ajcci/sky130_ajc_ip__por/doc/schematic/sky130_ajc_ip__por.html

# CACE 4.0 datasheet

sky130_ajc_ip__por

Power-on-reset

PDK: | sky130A

Designer: | Robin Matthew Tsang
Company: | Ajacci, Ltd. Co.
Created: | March 22, 2024
Last modified: | April 15, 2024 at 12:55pm
License: | Apache 2.0

## Pin names and descriptions


Project schematic symbol

pin name | description | type | direction | Vmin | Vmax | notes
vbg_1v2 | Bandgap reference 1.20V | signal | input | 1.15 | 1.25
otrip2:0 | Digital trip voltage select for brown-out detector | digital | input | dvss - 0.3 | dvdd + 0.3
force_pdn | Force power-down | digital | input | dvss - 0.3 | dvdd + 0.3
isrc_sel | Internal(0)/external(1) bias current select | digital | input | dvss - 0.3 | dvdd + 0.3
force_ena_rc_osc | Force internal rc-oscillator to turn on, test-mode | digital | input | dvss - 0.3 | dvdd + 0.3
force_dis_rc_osc | Force internal rc-oscillator to turn off, test-mode | digital | input | dvss - 0.3 | dvdd + 0.3
force_short_oneshot | Force one-shot timeout period to be very short, test-mode | digital | input | dvss - 0.3 | dvdd + 0.3
ibg_200n | External 200n bandgap reference current | signal | input | avss - 0.3 | avdd + 0.3
por | power-on-reset (active high) | digital | output | dvss - 0.3 | dvdd + 0.3
porb | power-on-reset (active low) | digital | output | dvss - 0.3 | dvdd + 0.3
porb_h | power-on-reset (active low 3v3) | digital | output | avss - 0.3 | avdd + 0.3
itest | Test current, send to external 1Mohm resistor if desired | signal | output | avss - 0.3 | avdd + 0.3
dvdd | Positive digital power supply | power | inout | 1.5 | 2.1
dvss | Digital ground | ground | inout | -0.3 | 0.3
avdd | Positive analog power supply | power | inout | 3.0 | 6.0
avss | Analog ground | ground | inout | -0.3 | 0.3
pwup_filt | Filtered analog comparator output, test-mode | digital | output | dvss - 0.3 | dvdd + 0.3
osc_ck | RC oscillator output | digital | output | dvss - 0.3 | dvdd + 0.3
vin | Analog input to comparator | signal | output | avss - 0.3 | avdd + 0.3
por_timed_out | Asserts high when one-shot timer expires after power-on-reset event ~50ms | digital | output | dvss - 0.3 | dvdd + 0.3
startup_timed_out | Asserts high when one-shot timer expires after initial powup-up for supply to stabilize ~1ms | digital | output | dvss - 0.3 | dvdd + 0.3
dcomp | Unfiltered analog comparator output, test-mode | digital | output | dvss - 0.3 | dvdd + 0.3

## Default conditions

name | description | unit | minimum | typical | maximum | notes
dvdd | Digital power supply voltage | V | | 1.8
dvss | Digital ground | V | | 0
avdd | Analog power supply voltage | V | | 3.3
avss | Analog ground | V | | 0
cload | Output load capatitance | pF | | | 20
force_pdn | Force diable of power-on-reset circuit | | | 0
isrc_sel | Internal(0)/external(1) bias current select | | | 0
force_ena_rc_osc | Force internal rc-oscillator to turn on, test-mode | | | 0
force_dis_rc_osc | Force internal rc-oscillator to turn on, test-mode | | | 0
force_short_oneshot | Force one-shot timeout period to be very short, test-mode | | | 0
otrip[2:0] | Brown-out trip voltage digital input value | | | 100
Temp | Ambient temperature | °C | -40 | 27 | 130
Corner | Process corner | | ss | tt | ff

## Electrical parameters

name | description | unit | minimum | typical | maximum | notes
Hysteresis (out) | Check amount of hysteresis at each trip voltage | V | 0.1138 | 0.1557 | 0.2062
Accuracy (out) | Check absolute accuracy of trip voltages (avg of pos- and neg-ramp trip voltages) | V | -0.002 | -0.001057 | 0.00208
Startup time (actual) | Measure time between when avdd crosses trip voltage to when POR reset is active, allows power supply to stabilize | ms | 0.7217 | 0.9965 | 1.558
Reset active time (est.) | Estimate reset active time by check rc oscillator period across 10 cycles, then multiplying by 2048. | ms | 40.23 | 54.01 | 88.05
Idd | Current draw through analog supply, POR enabled | µA | 4.322 | 4.555 | 4.711
Standby current | Current draw through analog supply, POR disabled | µA | 0.001176 | 0.001811 | 0.03704

Note: Values taken from Schematic captured


Demo of power-on-reset during a supply ramp and supply glitch with test-mode force_short_oneshot enabled. Shortens startup to and reset active windows to 4 and 8 osc_ck cycles, from 32 and 2048 osc_ck cycles.
(Values taken from schematic extraction)
