ajcci/sky130_ajc_ip__por/openlane/por_dig/runs/RUN_2024-04-15_08-19-42/50-openroad-irdropreport/net-VPWR.csv

Instance name | X location | Y location | Voltage
FILLER_0_16_29 | 21.84 | 57.12 | 1.8
_098_ | 21.84 | 51.68 | 1.8
_103_ | 21.84 | 51.68 | 1.8
_124_ | 21.84 | 51.68 | 1.8
hold4 | 21.84 | 51.68 | 1.8
_058_ | 21.84 | 46.24 | 1.8
_073_ | 21.84 | 46.24 | 1.8
_101_ | 21.84 | 46.24 | 1.8
_102_ | 21.84 | 46.24 | 1.8
_105_ | 21.84 | 46.24 | 1.8
FILLER_0_14_37 | 21.84 | 46.24 | 1.8
_055_ | 21.84 | 40.8 | 1.8
_059_ | 21.84 | 40.8 | 1.8
_060_ | 21.84 | 40.8 | 1.8
_084_ | 21.84 | 40.8 | 1.8
_097_ | 21.84 | 40.8 | 1.8
hold12 | 21.84 | 40.8 | 1.8
FILLER_0_11_37 | 21.84 | 40.8 | 1.8
_114_ | 21.84 | 35.36 | 1.8
_123_ | 21.84 | 35.36 | 1.8
clkbuf_0_osc_ck | 21.84 | 35.36 | 1.8
_074_ | 21.84 | 29.92 | 1.8
_106_ | 21.84 | 29.92 | 1.8
hold8 | 21.84 | 29.92 | 1.8
hold9 | 21.84 | 29.92 | 1.8
_072_ | 21.84 | 24.48 | 1.8
_115_ | 21.84 | 24.48 | 1.8
_116_ | 21.84 | 24.48 | 1.8
_075_ | 21.84 | 19.04 | 1.8
_077_ | 21.84 | 19.04 | 1.8
output12 | 21.84 | 19.04 | 1.8
fanout24 | 21.84 | 19.04 | 1.8
hold1 | 21.84 | 19.04 | 1.8
FILLER_0_2_35 | 21.84 | 19.04 | 1.8
FILLER_0_3_38 | 21.84 | 19.04 | 1.8
_062_ | 21.84 | 13.6 | 1.8
_063_ | 21.84 | 13.6 | 1.8
_065_ | 21.84 | 13.6 | 1.8
_068_ | 21.84 | 13.6 | 1.8
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
