ajcci/sky130_ajc_ip__por/coupling_caps_extraction_slowest_corner.png

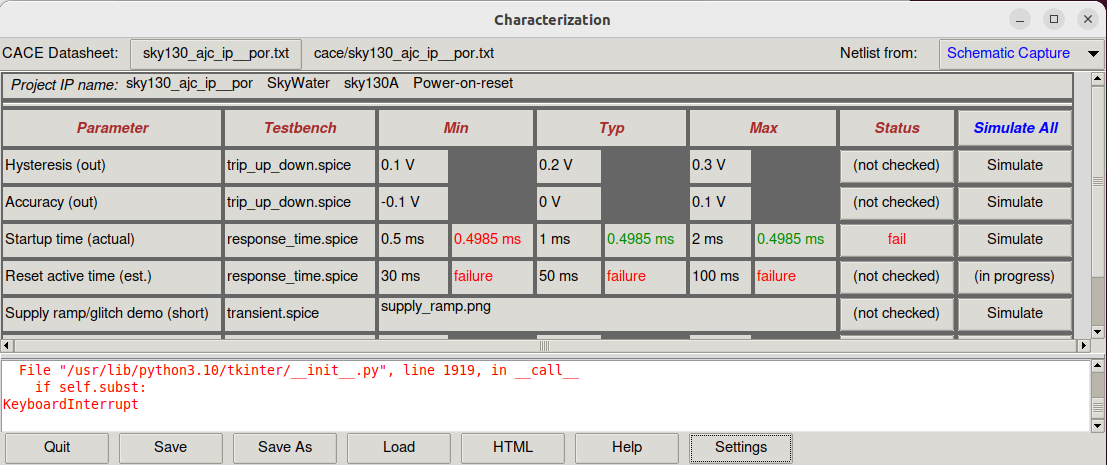
coupling_caps_extraction_slowest_corner.png
