ajcci/sky130_ajc_ip__por/plots/schematic/supply_ramp.png

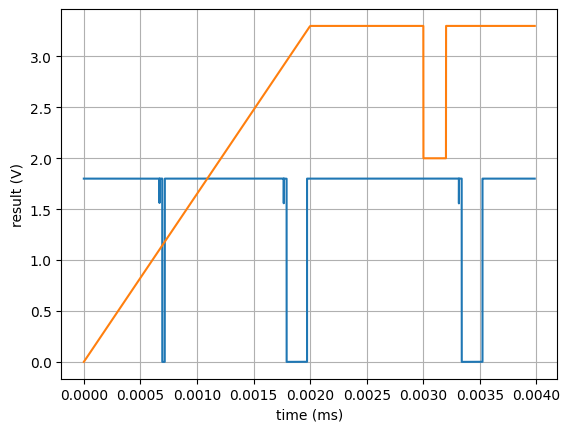
plots/schematic/supply_ramp.png
