ajcci/sky130_ajc_ip__por/unconnected_node_coupling_caps_extraction.png

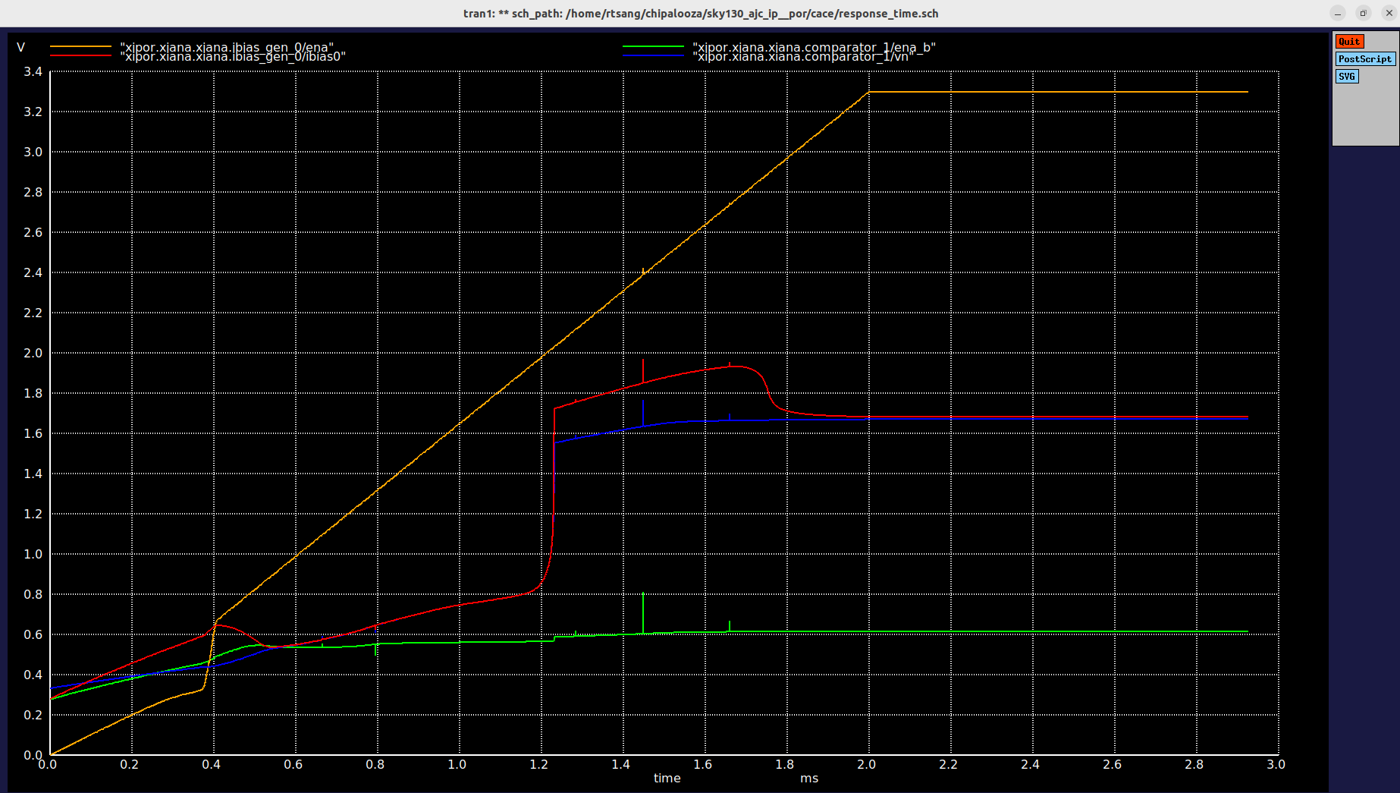
unconnected_node_coupling_caps_extraction.png
