ajcci/sky130_ajc_ip__por/cace/dccurrent_avdd.spice

** sch_path: /home/rtsang/chipalooza/sky130_ajc_ip__por/cace/dccurrent_avdd.sch
**.subckt dccurrent_avdd
Ibias vbp GND 200n
XM1 ibg_200n vbp avdd_bg avdd_bg sky130_fd_pr__pfet_g5v0d10v5 L=4 W=1 nf=1 ad='int((nf+1)/2) * W/nf * 0.29' as='int((nf+2)/2) * W/nf * 0.29'
+ pd='2*int((nf+1)/2) * (W/nf + 0.29)' ps='2*int((nf+2)/2) * (W/nf + 0.29)' nrd='0.29 / W' nrs='0.29 / W' sa=0 sb=0 sd=0 mult=1 m=1
XM0 vbp vbp avdd_bg avdd_bg sky130_fd_pr__pfet_g5v0d10v5 L=4 W=1 nf=1 ad='int((nf+1)/2) * W/nf * 0.29' as='int((nf+2)/2) * W/nf * 0.29'
+ pd='2*int((nf+1)/2) * (W/nf + 0.29)' ps='2*int((nf+2)/2) * (W/nf + 0.29)' nrd='0.29 / W' nrs='0.29 / W' sa=0 sb=0 sd=0 mult=1 m=1
Vavss avss GND DC {Vavss}
Vena force_pdn GND DC [{force_pdn}*{Vdvdd}]
Vavdd avdd GND DC {Vavdd}
.save i(vavdd)
Vbg1v2 vbg_1v2 GND DC 1.2
Vdvss dvss GND DC {Vdvss}
Vdvdd dvdd GND DC {Vdvdd}
.save i(vdvdd)
Vvotrip0 otrip[0] GND DC [{otrip[0]}*{Vdvdd}]
.save i(vvotrip0)
Vvotrip1 otrip[1] GND DC [{otrip[1]}*{Vdvdd}]
.save i(vvotrip1)
Vvotrip2 otrip[2] GND DC [{otrip[2]}*{Vdvdd}]
.save i(vvotrip2)
Vvotrip3 otrip[3] GND DC [{otrip[3]}*{Vdvdd}]
.save i(vvotrip3)
Visrc_sel isrc_sel GND DC [{isrc_sel}*{Vdvdd}]
Vavdd_bg avdd_bg GND DC 3.3
Vforce_dis_rc_osc force_dis_rc_osc GND DC [{force_dis_rc_osc}*{Vdvdd}]
Vforce_short_oneshot force_short_oneshot GND DC [{force_short_oneshot}*{Vdvdd}]
Vforce_ena_rc_osc force_ena_rc_osc GND DC [{force_ena_rc_osc}*{Vdvdd}]
R1 itest GND 1e6 m=1
xIpor avdd porb_h porb avss dvdd por dvss osc_ck vbg_1v2 dcomp otrip[2] otrip[1] otrip[0] itest force_pdn pwup_filt vin
+ force_ena_rc_osc force_dis_rc_osc startup_timed_out por_timed_out force_short_oneshot isrc_sel ibg_200n sky130_ajc_ip__por
C1 porb_h GND 20p m=1
C2 porb GND 20p m=1
C3 por GND 20p m=1
**** begin user architecture code

* CACE gensim simulation file {filename}_{N}
* Generated by CACE gensim, Efabless Corporation (c) 2023
* Find trip voltage by ramping Vavdd, both up and down.

.lib {PDK_ROOT}/{PDK}/libs.tech/combined/sky130.lib.spice {corner}
.include {PDK_ROOT}/{PDK}/libs.ref/sky130_fd_sc_hvl/spice/sky130_fd_sc_hvl.spice
.include {PDK_ROOT}/{PDK}/libs.ref/sky130_fd_sc_hd/spice/sky130_fd_sc_hd.spice

.option TEMP={temperature}
* Flag unsafe operating conditions (exceeds models' specified limits)
.option warn=1

.option reltol=1e-3
.option abstol=1e-3

.save all



.control
op
set wr_singlescale
wrdata {simpath}/{filename}_{N}.data -I(Vavdd)
quit
.endc


**** end user architecture code
**.ends

* expanding   symbol:  xschem/sky130_ajc_ip__por.sym # of pins=22
** sym_path: /home/rtsang/chipalooza/sky130_ajc_ip__por/xschem/sky130_ajc_ip__por.sym
** sch_path: /home/rtsang/chipalooza/sky130_ajc_ip__por/xschem/sky130_ajc_ip__por.sch
.subckt sky130_ajc_ip__por avdd porb_h porb avss dvdd por dvss osc_ck vbg_1v2 dcomp otrip[2] otrip[1] otrip[0] itest force_pdn pwup_filt vin force_ena_rc_osc force_dis_rc_osc startup_timed_out por_timed_out force_short_oneshot isrc_sel ibg_200n
*.ipin avdd
*.ipin avss
*.ipin dvdd
*.ipin dvss
*.ipin vbg_1v2
*.ipin otrip[2],otrip[1],otrip[0]
*.ipin force_pdn
*.ipin force_ena_rc_osc
*.ipin force_short_oneshot
*.ipin isrc_sel
*.ipin ibg_200n
*.opin vin
*.opin porb_h
*.opin porb
*.opin por
*.opin osc_ck
*.opin pwup_filt
*.opin itest
*.opin startup_timed_out
*.opin por_timed_out
*.ipin force_dis_rc_osc
*.opin dcomp
xIana vin otrip_decoded_7_ otrip_decoded_6_ otrip_decoded_5_ otrip_decoded_4_ otrip_decoded_3_ otrip_decoded_2_ otrip_decoded_1_ otrip_decoded_0_ vbg_1v2 avdd itest avss ibg_200n force_pdnb dvdd dvss dcomp isrc_sel pwup_filt osc_ck osc_ena porb_h por_unbuf por porb por_ana
**** begin user architecture code



r0 otrip[0] otrip0 1
r1 otrip[1] otrip1 1
r2 otrip[2] otrip2 1

*XSPICE CO-SIM netlist
.include por_dig.out.spice
xipor_dig dvss dvdd force_dis_rc_osc force_ena_rc_osc force_pdn force_pdnb force_short_oneshot osc_ck osc_ena
+otrip0 otrip1 otrip2
+otrip_decoded_0_ otrip_decoded_1_ otrip_decoded_2_ otrip_decoded_3_ otrip_decoded_4_ otrip_decoded_5_ otrip_decoded_6_ otrip_decoded_7_
+por_timed_out por_unbuf pwup_filt startup_timed_out por_dig


**** end user architecture code
.ends


* expanding   symbol:  xschem/por_ana.sym # of pins=19
** sym_path: /home/rtsang/chipalooza/sky130_ajc_ip__por/xschem/por_ana.sym
** sch_path: /home/rtsang/chipalooza/sky130_ajc_ip__por/xschem/por_ana.sch
.subckt por_ana vin otrip_decoded[7] otrip_decoded[6] otrip_decoded[5] otrip_decoded[4] otrip_decoded[3] otrip_decoded[2] otrip_decoded[1] otrip_decoded[0] vbg_1v2 avdd itest avss ibg_200n force_pdnb dvdd dvss dcomp isrc_sel pwup_filt osc_ck osc_ena porb_h por_unbuf por porb
*.ipin vbg_1v2
*.ipin avdd
*.ipin avss
*.ipin dvdd
*.ipin dvss
*.ipin force_pdnb
*.ipin isrc_sel
*.ipin ibg_200n
*.opin pwup_filt
*.opin itest
*.ipin osc_ena
*.opin osc_ck
*.ipin otrip_decoded[7],otrip_decoded[6],otrip_decoded[5],otrip_decoded[4],otrip_decoded[3],otrip_decoded[2],otrip_decoded[1],otrip_decoded[0]
*.opin vin
*.ipin por_unbuf
*.opin porb_h
*.opin por
*.opin porb
*.opin dcomp
xIlvls0 dcomp3v3 dvdd dvss dvss avdd avdd vl sky130_fd_sc_hvl__lsbufhv2lv_1
XC2 dcomp_filt dvss sky130_fd_pr__cap_mim_m3_2 W=30 L=30 MF=6 m=6
xIlvls0[7] otrip_decoded[7] dvdd dvss dvss avdd avdd otrip_decoded_avdd[7] sky130_fd_sc_hvl__lsbuflv2hv_1
xIlvls0[6] otrip_decoded[6] dvdd dvss dvss avdd avdd otrip_decoded_avdd[6] sky130_fd_sc_hvl__lsbuflv2hv_1
xIlvls0[5] otrip_decoded[5] dvdd dvss dvss avdd avdd otrip_decoded_avdd[5] sky130_fd_sc_hvl__lsbuflv2hv_1
xIlvls0[4] otrip_decoded[4] dvdd dvss dvss avdd avdd otrip_decoded_avdd[4] sky130_fd_sc_hvl__lsbuflv2hv_1
xIlvls0[3] otrip_decoded[3] dvdd dvss dvss avdd avdd otrip_decoded_avdd[3] sky130_fd_sc_hvl__lsbuflv2hv_1
xIlvls0[2] otrip_decoded[2] dvdd dvss dvss avdd avdd otrip_decoded_avdd[2] sky130_fd_sc_hvl__lsbuflv2hv_1
xIlvls0[1] otrip_decoded[1] dvdd dvss dvss avdd avdd otrip_decoded_avdd[1] sky130_fd_sc_hvl__lsbuflv2hv_1
xIlvls0[0] otrip_decoded[0] dvdd dvss dvss avdd avdd otrip_decoded_avdd[0] sky130_fd_sc_hvl__lsbuflv2hv_1
xIlvls1 force_pdnb dvdd dvss dvss avdd avdd force_pdnb_avdd sky130_fd_sc_hvl__lsbuflv2hv_1
xIlvls2 isrc_sel dvdd dvss dvss avdd avdd isrc_sel_avdd sky130_fd_sc_hvl__lsbuflv2hv_1
xIrsmux avdd vin force_pdnb_avdd otrip_decoded_avdd[7] otrip_decoded_avdd[6] otrip_decoded_avdd[5] otrip_decoded_avdd[4] otrip_decoded_avdd[3] otrip_decoded_avdd[2] otrip_decoded_avdd[1] otrip_decoded_avdd[0] vtrip_decoded_avdd[7] vtrip_decoded_avdd[6] vtrip_decoded_avdd[5] vtrip_decoded_avdd[4] vtrip_decoded_avdd[3] vtrip_decoded_avdd[2] vtrip_decoded_avdd[1] vtrip_decoded_avdd[0] not_used avss rstring_mux
xIcomp avdd ibias0 dcomp3v3 force_pdnb_avdd vbg_1v2 vin avss comparator
xIbiasgen avdd ibias0 itest ibias1 ibg_200n vbg_1v2 isrc_sel_avdd force_pdnb_avdd net8 avss ibias_gen
xIosc dvdd osc_ck osc_ena dvss rc_osc
xIlvls3 por_unbuf dvdd dvss dvss avdd avdd net1 sky130_fd_sc_hvl__lsbuflv2hv_1
xIinv4 por_unbuf dvss dvss dvdd dvdd net4 sky130_fd_sc_hd__inv_4
xIinv5 net4 dvss dvss dvdd dvdd por sky130_fd_sc_hd__inv_16
xIinv7 net6 dvss dvss dvdd dvdd net5 sky130_fd_sc_hd__inv_4
xIinv88 net5 dvss dvss dvdd dvdd porb sky130_fd_sc_hd__inv_16
xIinv6 por_unbuf dvss dvss dvdd dvdd net6 sky130_fd_sc_hd__inv_4
xIinv8 net3 avss avss avdd avdd porb_h sky130_fd_sc_hvl__inv_16
xIinv2 net2 avss avss avdd avdd net3 sky130_fd_sc_hvl__inv_4
xIinv1 net1 avss avss avdd avdd net2 sky130_fd_sc_hvl__inv_1
xIschmitt dvdd dcomp_filt vsch dvss schmitt_trigger
xIinv3 net7 dvss dvss dvdd dvdd pwup_filt sky130_fd_sc_hd__inv_16
xIinv9 vsch dvss dvss dvdd dvdd net7 sky130_fd_sc_hd__inv_4
XR2 dcomp_filt vl avss sky130_fd_pr__res_xhigh_po_1p41 L=700 mult=1 m=1
xIlvls3[7] dvss dvdd dvss dvss avdd avdd vtrip_decoded_avdd[7] sky130_fd_sc_hvl__lsbuflv2hv_1
xIlvls3[6] dvss dvdd dvss dvss avdd avdd vtrip_decoded_avdd[6] sky130_fd_sc_hvl__lsbuflv2hv_1
xIlvls3[5] dvss dvdd dvss dvss avdd avdd vtrip_decoded_avdd[5] sky130_fd_sc_hvl__lsbuflv2hv_1
xIlvls3[4] dvss dvdd dvss dvss avdd avdd vtrip_decoded_avdd[4] sky130_fd_sc_hvl__lsbuflv2hv_1
xIlvls3[3] dvss dvdd dvss dvss avdd avdd vtrip_decoded_avdd[3] sky130_fd_sc_hvl__lsbuflv2hv_1
xIlvls3[2] dvss dvdd dvss dvss avdd avdd vtrip_decoded_avdd[2] sky130_fd_sc_hvl__lsbuflv2hv_1
xIlvls3[1] dvss dvdd dvss dvss avdd avdd vtrip_decoded_avdd[1] sky130_fd_sc_hvl__lsbuflv2hv_1
xIlvls3[0] dvss dvdd dvss dvss avdd avdd vtrip_decoded_avdd[0] sky130_fd_sc_hvl__lsbuflv2hv_1
xIcomp_vunder avdd ibias1 net9 avss not_used vbg_1v2 avss comparator
xIlvls5 net9 dvdd dvss dvss avdd avdd vlu sky130_fd_sc_hvl__lsbufhv2lv_1
* noconn vlu
xIinv10 vl dvss dvss dvdd dvdd net10 sky130_fd_sc_hd__inv_4
xIinv11 net10 dvss dvss dvdd dvdd dcomp sky130_fd_sc_hd__inv_16
XQ1 avss avss net8 avss sky130_fd_pr__pnp_05v5_W0p68L0p68 m=1 mult=1
.ends


* expanding   symbol:  rstring_mux.sym # of pins=7
** sym_path: /home/rtsang/chipalooza/sky130_ajc_ip__por/cace/rstring_mux.sym
** sch_path: /home/rtsang/chipalooza/sky130_ajc_ip__por/cace/rstring_mux.sch
.subckt rstring_mux avdd vout_brout ena otrip_decoded_avdd[7] otrip_decoded_avdd[6] otrip_decoded_avdd[5] otrip_decoded_avdd[4] otrip_decoded_avdd[3] otrip_decoded_avdd[2] otrip_decoded_avdd[1] otrip_decoded_avdd[0] vtrip_decoded_avdd[7] vtrip_decoded_avdd[6] vtrip_decoded_avdd[5] vtrip_decoded_avdd[4] vtrip_decoded_avdd[3] vtrip_decoded_avdd[2] vtrip_decoded_avdd[1] vtrip_decoded_avdd[0] vout_vunder avss
*.opin vout_brout
*.ipin otrip_decoded_avdd[7],otrip_decoded_avdd[6],otrip_decoded_avdd[5],otrip_decoded_avdd[4],otrip_decoded_avdd[3],otrip_decoded_avdd[2],otrip_decoded_avdd[1],otrip_decoded_avdd[0]
*.opin vout_vunder
*.ipin vtrip_decoded_avdd[7],vtrip_decoded_avdd[6],vtrip_decoded_avdd[5],vtrip_decoded_avdd[4],vtrip_decoded_avdd[3],vtrip_decoded_avdd[2],vtrip_decoded_avdd[1],vtrip_decoded_avdd[0]
*.ipin ena
*.ipin avdd
*.ipin avss
XR1 net2 net3 avss sky130_fd_pr__res_xhigh_po_1p41 L=35 mult=1 m=1
XR2 net3 net4 avss sky130_fd_pr__res_xhigh_po_1p41 L=35 mult=1 m=1
XR0 avss net2 avss sky130_fd_pr__res_xhigh_po_1p41 L=35 mult=1 m=1
XR3 net4 net5 avss sky130_fd_pr__res_xhigh_po_1p41 L=35 mult=1 m=1
XR4 net5 net6 avss sky130_fd_pr__res_xhigh_po_1p41 L=35 mult=1 m=1
XR5 net6 net7 avss sky130_fd_pr__res_xhigh_po_1p41 L=35 mult=1 m=1
XR6 net7 net8 avss sky130_fd_pr__res_xhigh_po_1p41 L=35 mult=1 m=1
XR7 net8 net9 avss sky130_fd_pr__res_xhigh_po_1p41 L=35 mult=1 m=1
XR8 net9 net10 avss sky130_fd_pr__res_xhigh_po_1p41 L=35 mult=1 m=1
XR9 net10 net11 avss sky130_fd_pr__res_xhigh_po_1p41 L=35 mult=1 m=1
XR10 net11 net12 avss sky130_fd_pr__res_xhigh_po_1p41 L=35 mult=1 m=1
XR11 net12 net13 avss sky130_fd_pr__res_xhigh_po_1p41 L=35 mult=1 m=1
XR12 net13 net14 avss sky130_fd_pr__res_xhigh_po_1p41 L=35 mult=1 m=1
XR13 net14 net15 avss sky130_fd_pr__res_xhigh_po_1p41 L=35 mult=1 m=1
XR14 net15 net16 avss sky130_fd_pr__res_xhigh_po_1p41 L=35 mult=1 m=1
XR15 net16 net17 avss sky130_fd_pr__res_xhigh_po_1p41 L=35 mult=1 m=1
XR16 net17 net18 avss sky130_fd_pr__res_xhigh_po_1p41 L=35 mult=1 m=1
XR17 net18 net19 avss sky130_fd_pr__res_xhigh_po_1p41 L=35 mult=1 m=1
XR18 net19 net20 avss sky130_fd_pr__res_xhigh_po_1p41 L=35 mult=1 m=1
XR19 net20 net21 avss sky130_fd_pr__res_xhigh_po_1p41 L=35 mult=1 m=1
XR20 net21 net22 avss sky130_fd_pr__res_xhigh_po_1p41 L=35 mult=1 m=1
XR21 net22 net23 avss sky130_fd_pr__res_xhigh_po_1p41 L=35 mult=1 m=1
XR22 net23 net24 avss sky130_fd_pr__res_xhigh_po_1p41 L=35 mult=1 m=1
XR23 net24 net25 avss sky130_fd_pr__res_xhigh_po_1p41 L=35 mult=1 m=1
XR24 net25 net26 avss sky130_fd_pr__res_xhigh_po_1p41 L=35 mult=1 m=1
XR25 net26 net27 avss sky130_fd_pr__res_xhigh_po_1p41 L=35 mult=1 m=1
XR26 net27 net28 avss sky130_fd_pr__res_xhigh_po_1p41 L=35 mult=1 m=1
XR27 net28 vtrip7 avss sky130_fd_pr__res_xhigh_po_1p41 L=35 mult=1 m=1
XR28 vtrip7 vtrip6 avss sky130_fd_pr__res_xhigh_po_1p41 L=35 mult=1 m=1
XR29 vtrip6 vtrip5 avss sky130_fd_pr__res_xhigh_po_1p41 L=35 mult=1 m=1
XR30 vtrip5 vtrip4 avss sky130_fd_pr__res_xhigh_po_1p41 L=35 mult=1 m=1
XR31 vtrip4 vtrip3 avss sky130_fd_pr__res_xhigh_po_1p41 L=35 mult=1 m=1
XR32 vtrip3 vtrip2 avss sky130_fd_pr__res_xhigh_po_1p41 L=35 mult=1 m=1
XR33 vtrip2 vtrip1 avss sky130_fd_pr__res_xhigh_po_1p41 L=35 mult=1 m=1
XR34 vtrip1 vtrip0 avss sky130_fd_pr__res_xhigh_po_1p41 L=35 mult=1 m=1
XR35 vtrip0 net29 avss sky130_fd_pr__res_xhigh_po_1p41 L=35 mult=1 m=1
XR36 net29 net30 avss sky130_fd_pr__res_xhigh_po_1p41 L=35 mult=1 m=1
XR37 net30 net31 avss sky130_fd_pr__res_xhigh_po_1p41 L=35 mult=1 m=1
XR38 net31 net32 avss sky130_fd_pr__res_xhigh_po_1p41 L=35 mult=1 m=1
XR39 net32 net33 avss sky130_fd_pr__res_xhigh_po_1p41 L=35 mult=1 m=1
XR40 net33 net34 avss sky130_fd_pr__res_xhigh_po_1p41 L=35 mult=1 m=1
XR41 net34 net35 avss sky130_fd_pr__res_xhigh_po_1p41 L=35 mult=1 m=1
XR42 net35 net36 avss sky130_fd_pr__res_xhigh_po_1p41 L=35 mult=1 m=1
XR43 net36 net37 avss sky130_fd_pr__res_xhigh_po_1p41 L=35 mult=1 m=1
XR44 net37 net38 avss sky130_fd_pr__res_xhigh_po_1p41 L=35 mult=1 m=1
XR45 net38 net39 avss sky130_fd_pr__res_xhigh_po_1p41 L=35 mult=1 m=1
XR46 net39 net40 avss sky130_fd_pr__res_xhigh_po_1p41 L=35 mult=1 m=1
XR47 net40 net41 avss sky130_fd_pr__res_xhigh_po_1p41 L=35 mult=1 m=1
XR48 net41 net42 avss sky130_fd_pr__res_xhigh_po_1p41 L=35 mult=1 m=1
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
XMtn1[2] vout_vunder vtrip_decoded_avdd[2] vtrip2 avss sky130_fd_pr__nfet_g5v0d10v5 L=0.6 W=5 nf=1 ad='int((nf+1)/2) * W/nf * 0.29' as='int((nf+2)/2)
+ * W/nf * 0.29' pd='2*int((nf+1)/2) * (W/nf + 0.29)' ps='2*int((nf+2)/2) * (W/nf + 0.29)' nrd='0.29 / W' nrs='0.29 / W' sa=0 sb=0 sd=0 mult=2 m=2
XMtn1[1] vout_vunder vtrip_decoded_avdd[1] vtrip1 avss sky130_fd_pr__nfet_g5v0d10v5 L=0.6 W=5 nf=1 ad='int((nf+1)/2) * W/nf * 0.29' as='int((nf+2)/2)
+ * W/nf * 0.29' pd='2*int((nf+1)/2) * (W/nf + 0.29)' ps='2*int((nf+2)/2) * (W/nf + 0.29)' nrd='0.29 / W' nrs='0.29 / W' sa=0 sb=0 sd=0 mult=2 m=2
XMtn1[0] vout_vunder vtrip_decoded_avdd[0] vtrip0 avss sky130_fd_pr__nfet_g5v0d10v5 L=0.6 W=5 nf=1 ad='int((nf+1)/2) * W/nf * 0.29' as='int((nf+2)/2)
+ * W/nf * 0.29' pd='2*int((nf+1)/2) * (W/nf + 0.29)' ps='2*int((nf+2)/2) * (W/nf + 0.29)' nrd='0.29 / W' nrs='0.29 / W' sa=0 sb=0 sd=0 mult=2 m=2
xIinv0[7] otrip_decoded_avdd[7] avss avss avdd avdd otrip_decoded_b_avdd[7] sky130_fd_sc_hvl__inv_1
xIinv0[6] otrip_decoded_avdd[6] avss avss avdd avdd otrip_decoded_b_avdd[6] sky130_fd_sc_hvl__inv_1
xIinv0[5] otrip_decoded_avdd[5] avss avss avdd avdd otrip_decoded_b_avdd[5] sky130_fd_sc_hvl__inv_1
xIinv0[4] otrip_decoded_avdd[4] avss avss avdd avdd otrip_decoded_b_avdd[4] sky130_fd_sc_hvl__inv_1
xIinv0[3] otrip_decoded_avdd[3] avss avss avdd avdd otrip_decoded_b_avdd[3] sky130_fd_sc_hvl__inv_1
xIinv0[2] otrip_decoded_avdd[2] avss avss avdd avdd otrip_decoded_b_avdd[2] sky130_fd_sc_hvl__inv_1
xIinv0[1] otrip_decoded_avdd[1] avss avss avdd avdd otrip_decoded_b_avdd[1] sky130_fd_sc_hvl__inv_1
xIinv0[0] otrip_decoded_avdd[0] avss avss avdd avdd otrip_decoded_b_avdd[0] sky130_fd_sc_hvl__inv_1
xIinv1[7] vtrip_decoded_avdd[7] avss avss avdd avdd vtrip_decoded_b_avdd[7] sky130_fd_sc_hvl__inv_1
xIinv1[6] vtrip_decoded_avdd[6] avss avss avdd avdd vtrip_decoded_b_avdd[6] sky130_fd_sc_hvl__inv_1
xIinv1[5] vtrip_decoded_avdd[5] avss avss avdd avdd vtrip_decoded_b_avdd[5] sky130_fd_sc_hvl__inv_1
xIinv1[4] vtrip_decoded_avdd[4] avss avss avdd avdd vtrip_decoded_b_avdd[4] sky130_fd_sc_hvl__inv_1
xIinv1[3] vtrip_decoded_avdd[3] avss avss avdd avdd vtrip_decoded_b_avdd[3] sky130_fd_sc_hvl__inv_1
xIinv1[2] vtrip_decoded_avdd[2] avss avss avdd avdd vtrip_decoded_b_avdd[2] sky130_fd_sc_hvl__inv_1
xIinv1[1] vtrip_decoded_avdd[1] avss avss avdd avdd vtrip_decoded_b_avdd[1] sky130_fd_sc_hvl__inv_1
xIinv1[0] vtrip_decoded_avdd[0] avss avss avdd avdd vtrip_decoded_b_avdd[0] sky130_fd_sc_hvl__inv_1
xIinv2 ena avss avss avdd avdd ena_b sky130_fd_sc_hvl__inv_1
XMpdn net1 ena_b avss avss sky130_fd_pr__nfet_g5v0d10v5 L=1 W=1 nf=1 ad='int((nf+1)/2) * W/nf * 0.29' as='int((nf+2)/2) * W/nf * 0.29' pd='2*int((nf+1)/2)
+ * (W/nf + 0.29)' ps='2*int((nf+2)/2) * (W/nf + 0.29)' nrd='0.29 / W' nrs='0.29 / W' sa=0 sb=0 sd=0 mult=1 m=1
XMpdp avdd ena_b net1 avdd sky130_fd_pr__pfet_g5v0d10v5 L=0.6 W=5 nf=1 ad='int((nf+1)/2) * W/nf * 0.29' as='int((nf+2)/2) * W/nf *
+ 0.29' pd='2*int((nf+1)/2) * (W/nf + 0.29)' ps='2*int((nf+2)/2) * (W/nf + 0.29)' nrd='0.29 / W' nrs='0.29 / W' sa=0 sb=0 sd=0 mult=16 m=16
XMdum0 vout_brout avdd vout_brout avdd sky130_fd_pr__pfet_g5v0d10v5 L=0.6 W=5 nf=1 ad='int((nf+1)/2) * W/nf * 0.29' as='int((nf+2)/2)
+ * W/nf * 0.29' pd='2*int((nf+1)/2) * (W/nf + 0.29)' ps='2*int((nf+2)/2) * (W/nf + 0.29)' nrd='0.29 / W' nrs='0.29 / W' sa=0 sb=0 sd=0 mult=7 m=7
XMdum1 vout_brout avss vout_brout avss sky130_fd_pr__nfet_g5v0d10v5 L=0.6 W=5 nf=1 ad='int((nf+1)/2) * W/nf * 0.29' as='int((nf+2)/2)
+ * W/nf * 0.29' pd='2*int((nf+1)/2) * (W/nf + 0.29)' ps='2*int((nf+2)/2) * (W/nf + 0.29)' nrd='0.29 / W' nrs='0.29 / W' sa=0 sb=0 sd=0 mult=7 m=7
XMdum2 vout_brout avdd vout_vunder avdd sky130_fd_pr__pfet_g5v0d10v5 L=0.6 W=5 nf=1 ad='int((nf+1)/2) * W/nf * 0.29' as='int((nf+2)/2)
+ * W/nf * 0.29' pd='2*int((nf+1)/2) * (W/nf + 0.29)' ps='2*int((nf+2)/2) * (W/nf + 0.29)' nrd='0.29 / W' nrs='0.29 / W' sa=0 sb=0 sd=0 mult=1 m=1
XMdum3 vout_vunder avss vout_brout avss sky130_fd_pr__nfet_g5v0d10v5 L=0.6 W=5 nf=1 ad='int((nf+1)/2) * W/nf * 0.29' as='int((nf+2)/2)
+ * W/nf * 0.29' pd='2*int((nf+1)/2) * (W/nf + 0.29)' ps='2*int((nf+2)/2) * (W/nf + 0.29)' nrd='0.29 / W' nrs='0.29 / W' sa=0 sb=0 sd=0 mult=1 m=1
XMdum4 vout_vunder avdd vout_vunder avdd sky130_fd_pr__pfet_g5v0d10v5 L=0.6 W=5 nf=1 ad='int((nf+1)/2) * W/nf * 0.29' as='int((nf+2)/2)
+ * W/nf * 0.29' pd='2*int((nf+1)/2) * (W/nf + 0.29)' ps='2*int((nf+2)/2) * (W/nf + 0.29)' nrd='0.29 / W' nrs='0.29 / W' sa=0 sb=0 sd=0 mult=7 m=7
XMdum5 vout_vunder avss vout_vunder avss sky130_fd_pr__nfet_g5v0d10v5 L=0.6 W=5 nf=1 ad='int((nf+1)/2) * W/nf * 0.29' as='int((nf+2)/2)
+ * W/nf * 0.29' pd='2*int((nf+1)/2) * (W/nf + 0.29)' ps='2*int((nf+2)/2) * (W/nf + 0.29)' nrd='0.29 / W' nrs='0.29 / W' sa=0 sb=0 sd=0 mult=7 m=7
.ends
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
