ajcci/sky130_ajc_ip__por/mag/lvs/por_dig.pnl.v

module por_dig (force_dis_rc_osc,
    force_ena_rc_osc,
    force_pdn,
    force_pdnb,
    force_short_oneshot,
    osc_ck,
    osc_ena,
    por_timed_out,
    por_unbuf,
    pwup_filt,
    startup_timed_out,
    VPWR,
    VGND,
    otrip,
    otrip_decoded);
 input force_dis_rc_osc;
 input force_ena_rc_osc;
 input force_pdn;
 output force_pdnb;
 input force_short_oneshot;
 input osc_ck;
 output osc_ena;
 output por_timed_out;
 output por_unbuf;
 input pwup_filt;
 output startup_timed_out;
 input VPWR;
 input VGND;
 input [2:0] otrip;
 output [7:0] otrip_decoded;

 wire _000_;
 wire _001_;
 wire _002_;
 wire _003_;
 wire _004_;
 wire _005_;
 wire _006_;
 wire _007_;
 wire _008_;
 wire _009_;
 wire _010_;
 wire _011_;
 wire _012_;
 wire _013_;
 wire _014_;
 wire _015_;
 wire _016_;
 wire _017_;
 wire _018_;
 wire _019_;
 wire _020_;
 wire _021_;
 wire _022_;
 wire _023_;
 wire _024_;
 wire _025_;
 wire _026_;
 wire _027_;
 wire _028_;
 wire _029_;
 wire _030_;
 wire _031_;
 wire _032_;
 wire _033_;
 wire _034_;
 wire _035_;
 wire _036_;
 wire _037_;
 wire _038_;
 wire _039_;
 wire _040_;
 wire _041_;
 wire _042_;
 wire _043_;
 wire _044_;
 wire _045_;
 wire _046_;
 wire _047_;
 wire _048_;
 wire _049_;
 wire \cnt_por[0] ;
 wire \cnt_por[10] ;
 wire \cnt_por[1] ;
 wire \cnt_por[2] ;
 wire \cnt_por[3] ;
 wire \cnt_por[4] ;
 wire \cnt_por[5] ;
 wire \cnt_por[6] ;
 wire \cnt_por[7] ;
 wire \cnt_por[8] ;
 wire \cnt_por[9] ;
 wire cnt_rsb;
 wire cnt_rsb_stg1;
 wire \cnt_st[0] ;
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
    .VNB(VGND),
    .VPB(VPWR),
    .VPWR(VPWR));
 sky130_ef_sc_hd__decap_12 FILLER_0_16_85 (.VPWR(VPWR),
    .VGND(VGND),
    .VPB(VPWR),
    .VNB(VGND));
 sky130_fd_sc_hd__fill_2 FILLER_0_16_97 (.VGND(VGND),
    .VNB(VGND),
    .VPB(VPWR),
    .VPWR(VPWR));
endmodule
