ajcci/sky130_ajc_ip__por/(commit log)

2024-03-16 short_oneshot increased 4x for time_out period to 64 cycles
    [tb_por.sch]
2024-03-16 comparator hysteresis size
    [comparator.sch]
2024-03-18 slowed down clock, removed 256 ck
    [comparator.sch, ibias_gen.sch, por.sch, por_ana.sch, rc_osc.sch, rstring_mux.sch, tb_por.sch]
2024-03-23 Rev 0 commit
    [comparator.sch, dccurrent_avdd.sch, ibias_gen.sch, por.sch, por_ana.sch, rc_osc.sch, response_time.sch, rstring_mux.sch]
2024-04-14 commit for design review
    [dccurrent_avdd.sch, por_ana.sch, por_ana_cc.sch, por_ana_rcx.sch, rcx vs schematic.ods, response_time.sch, sky130_ajc_ip__por.sch, sky130_ajc_ip__por_lvs.sch]
2024-04-15 add digital ru
    [metrics.csv, net-VGND.csv, net-VPWR.csv, por_dig__max_ff_n40C_1v95.sdf, por_dig__max_ss_100C_1v60.sdf, por_dig__max_tt_025C_1v80.sdf, por_dig__min_ff_n40C_1v95.sdf, por_dig__min_ss_100C_1v60.sdf]
2024-04-15 swap back in por_ana after rcx
    [sky130_ajc_ip__por.sch]
2024-04-15 changed digital value where counter stops
    [metrics.csv, net-VGND.csv, net-VPWR.csv, por_dig__max_ff_n40C_1v95.sdf, por_dig__max_ss_100C_1v60.sdf, por_dig__max_tt_025C_1v80.sdf, por_dig__min_ff_n40C_1v95.sdf, por_dig__min_ss_100C_1v60.sdf]
